mattia-longobardo/Knobby/hardware/knobby-case.step

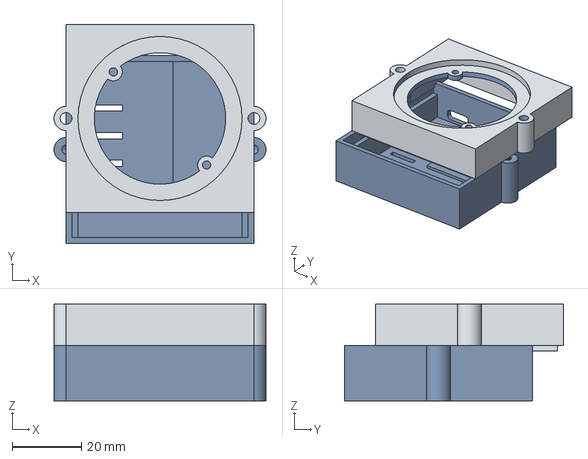
[picture p7: CAD file, 2026-08-10]
hardware/knobby-case.step
61.4 x 63.4 x 28.0 mm
Bottom Shell
Upper Shell
