mattia-longobardo/Knobby/(commit log)

2026-08-10 feat: battery-powered Home Assistant smart knob (ESP32-S3 + ESPHome + LVGL)
2026-08-10 feat(case): replace wall dock with 3D-printable case (STEP, M3 screws)
    [knobby-case.step]
